mjpalmowski/brain_zero/hardware/enclosure/placement-preview.png

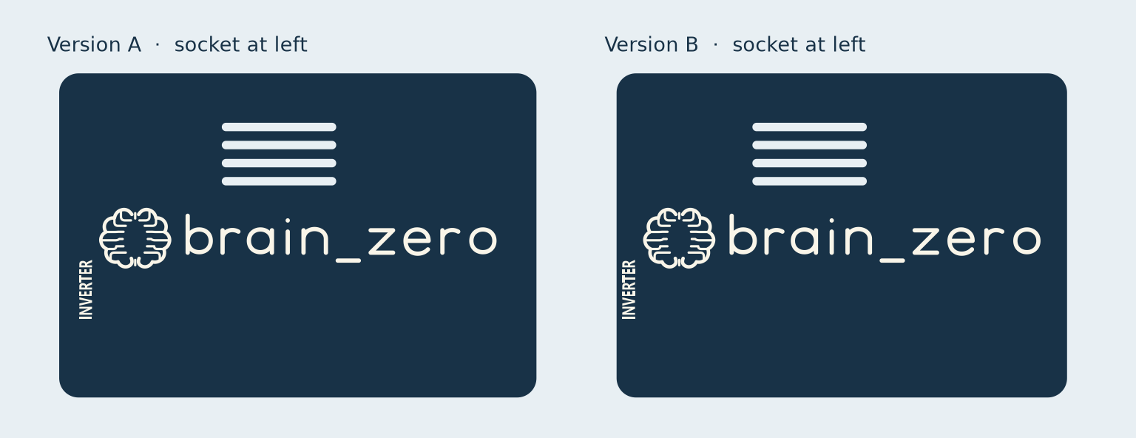
hardware/enclosure/placement-preview.png
