mjpalmowski/brain_zero/hardware/enclosure/version-b/brain-zero-version-b-smooth-lid.stl

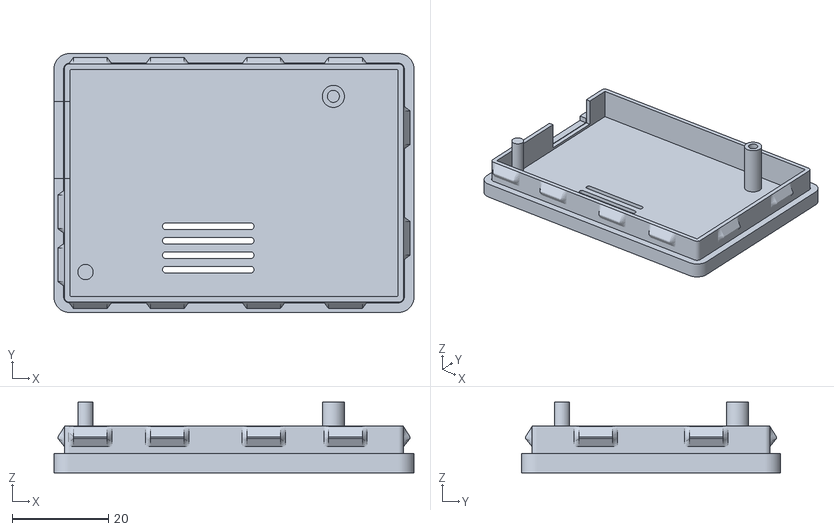
[picture p10: CAD file, 2026-11-10]
hardware/enclosure/version-b/brain-zero-version-b-smooth-lid.stl
74.8 x 53.8 x 14.8
