mjpalmowski/brain_zero/hardware/enclosure/version-b/brain-zero-version-b-base.stl

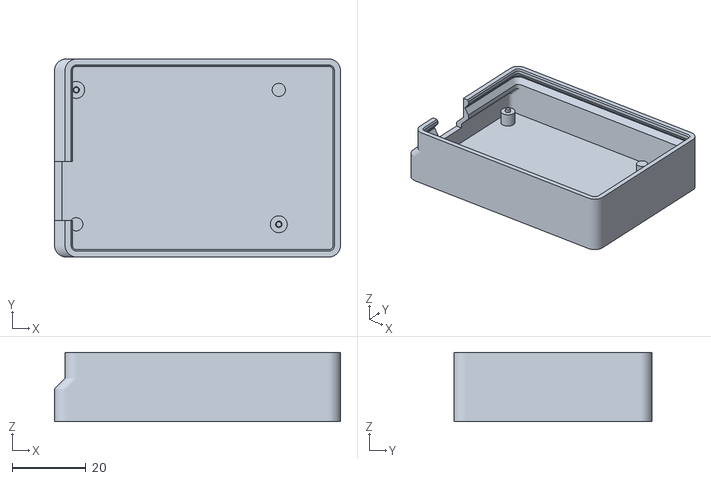
[picture p11: CAD file, 2026-11-10]
hardware/enclosure/version-b/brain-zero-version-b-base.stl
77.7 x 53.8 x 18.8
