mjpalmowski/brain_zero/hardware/enclosure/version-a/brain-zero-version-a-base.stl

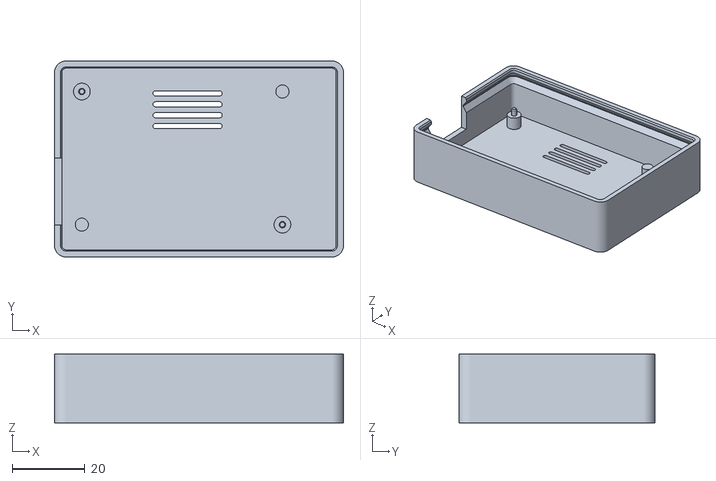
[picture p12: CAD file, 2026-11-10, an earlier design]
hardware/enclosure/version-a/brain-zero-version-a-base.stl
79.2 x 53.8 x 18.8
