mjpalmowski/brain_zero/hardware/enclosure/version-a/brain-zero-version-a-smooth-lid.stl

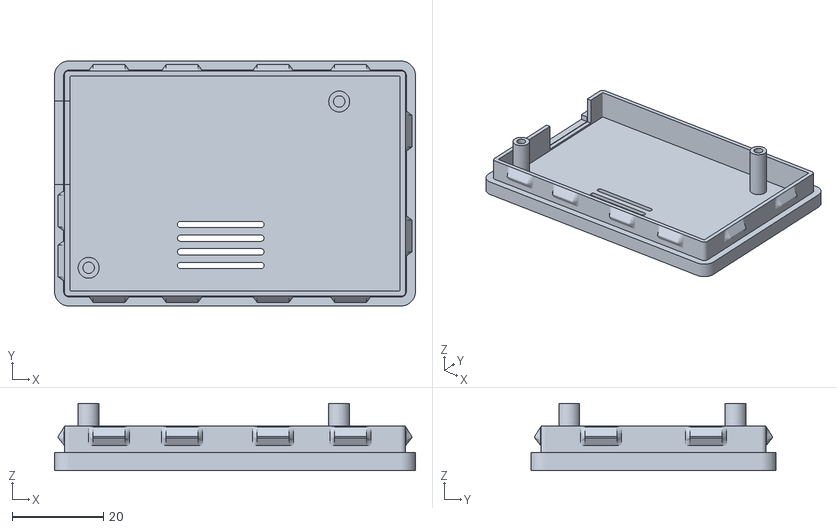
[picture p13: CAD file, 2026-11-10, an earlier design]
hardware/enclosure/version-a/brain-zero-version-a-smooth-lid.stl
79.2 x 53.8 x 14.8
