mjpalmowski/brain_zero/firmware/vebus_listener/src/upload.cpp

#include "upload.h"

#include <stdarg.h>
#include <stdio.h>
#include <string.h>

namespace upload {

const char *Uploader::state_name(State s) {
    static const char *const NAME[] = {"empty", "loaded", "reading", "writing", "verifying", "done", "failed"};
    return s <= FAILED ? NAME[s] : "?";
}

void Uploader::finish(State s, const char *fmt, ...) {
    check_.plan.access.erase_bytes();
    state_ = s;
    va_list a;
    va_start(a, fmt);
    vsnprintf(message_, sizeof message_, fmt, a);
    va_end(a);
}

bool Uploader::load(const uint8_t *data, size_t n, const char *name, char *why, size_t cap) {
    if (busy()) {
        snprintf(why, cap, "a file is being written: wait for it to finish");
        return false;
    }
    state_ = EMPTY;
    access_only_ = false;
    message_[0] = 0;
    check_.plan.access.clear();
    if (!rvsc::parse(data, n, file_, why, cap)) { file_.credentials.clear(); return false; }
    snprintf(name_, sizeof name_, "%s", name ? name : "");
    bytes_ = n;
    state_ = LOADED;
    return true;
}

void Uploader::clear() {
    if (busy()) return;
    state_ = EMPTY;
    access_only_ = false;
    name_[0] = message_[0] = 0;
    bytes_ = 0;
    file_.credentials.clear();
    check_.plan.access.clear();
    comparison_.plan.access.clear();
    memset(static_cast<void *>(&file_), 0, sizeof file_);
}

const rvsc::Check &Uploader::preview(const vebus::Requester::SettingsRead &read, int64_t utc) {
    rvsc::check(file_, read, comparison_, utc);
    comparison_.plan.access.erase_bytes();
    return comparison_;
}

bool Uploader::start(vebus::Requester &r, int64_t now, const char **why, bool access_only) {
    const char *w = state_ == EMPTY ? "no file loaded" : busy() ? "a file is already being written" : nullptr;
    if (!w && access_only && !file_.credentials.count) w = "no embedded credentials to test";
    if (!w && !r.read_settings(now)) w = "the Multi cannot be read now (the controller off, a test run, or a read or "
                                         "write running)";
    if (why) *why = w ? w : "";
    if (w) return false;
    started_ = read_started_ = now;
    access_only_ = access_only;
    state_ = READING;
    message_[0] = 0;
    return true;
}

bool Uploader::cancel(const char **why) {
    const char *w = state_ == READING ? nullptr
                    : busy()          ? "the Multi is being written: a write cannot be called off"
                                      : "nothing to call off";
    if (why) *why = w ? w : "";
    if (w) return false;
    finish(LOADED, "called off before anything was written");
    return true;
}
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
