mjpalmowski/brain_zero/(commit log)

2026-11-10 Accept compatibility profile downloads as attachments
2026-11-10 Check GitHub releases and stage updates from brain-zero.com
2026-11-10 Publish Rev C enclosure print files
    [brain-zero-version-a-base.stl, brain-zero-version-a-smooth-lid.stl, brain-zero-version-b-base.stl, brain-zero-version-b-smooth-lid.stl]
2026-11-10 Remove the virtual COM device before native file capture
2026-11-11 Prepare firmware-20261111.6 with current settings UI and OTA fixes
    [controller_time.cpp, controller_time.h, controller_time_test.cpp, diagnostics.h]
2026-11-11 Unify firmware and move installation charging plans into Home Assistant
2026-11-11 Keep Home Assistant telemetry polling active during charging updates
2026-11-11 Reference esp32ess as a DIY hardware solution
2026-11-11 Add 5 V ESP32-S3 DIY tutorial and VE.Bus wiring diagram
2026-11-11 Require an isolated 5 V supply in the DIY guide
2026-11-11 Simplify submission summary to model voltage and firmware
2026-11-12 Qualify nonempty legacy Assistant replacement
    [diagnostics.h, requester.cpp, rvsc.cpp, rvsc.h]
2026-11-12 Reserve OTA downloads against automatic charger refresh
